DavidManzano04/control-acceso-iot/hardware/BOM_NODO_ACCESO.csv

Cantidad | Referencias | Valor | Huella (KiCad) | Parte sugerida | LCSC
1 | C1 | 100uF 25V | Capacitor_SMD:CP_Elec_6.3x7.7 | Aluminio SMD 100 uF 25 V 6.3 mm | C2941301
1 | C2 | 10uF 50V | Capacitor_SMD:C_1206_3216Metric | X5R 1206 10 uF 25 V | C13585
3 | C3 C8 C10 | 100nF | Capacitor_SMD:C_0603_1608Metric |  | C14663
2 | C4 C5 | 22uF 25V | Capacitor_SMD:C_1206_3216Metric |  | C12891
1 | C6 | 10uF 25V | Capacitor_SMD:C_0805_2012Metric |  | C15850
2 | C7 C9 | 22uF 25V | Capacitor_SMD:C_0805_2012Metric |  | C45783
1 | C11 | 1uF | Capacitor_SMD:C_0603_1608Metric |  | C15849
1 | D1 | SS34 | Diode_SMD:D_SMA | SS34 (3 A, 40 V) | C8678
1 | D2 | SMBJ15CA | Diode_SMD:D_SMB | SMBJ15CA | C8829
2 | D3 D4 | SS34 | Diode_SMD:D_SMA | SS34 | C8678
1 | D5 | PWR (rojo) | LED_SMD:LED_0603_1608Metric |  | C2286
1 | D6 | ESTADO (verde) | LED_SMD:LED_0603_1608Metric |  | C72043
1 | F1 | PTC 1.1A 16V | Fuse:Fuse_1812_4532Metric | JK-mSMD110-16 (1812, 1.1 A, 16 V) | C369171
1 | J1 | ENTRADA 12V | TerminalBlock_Phoenix:TerminalBlock_Phoenix_MKDS-1,5-2-5.08_1x02_P5.08mm_Horizontal | Phoenix MKDS 1,5/2-5,08 (1715721) | (soldar a mano)
1 | J2 | USB-C | Connector_USB:USB_C_Receptacle_HRO_TYPE-C-31-M-12 | Korean Hroparts TYPE-C-31-M-12 | C165948
1 | J3 | LECTOR | TerminalBlock_Phoenix:TerminalBlock_Phoenix_MKDS-1,5-4-5.08_1x04_P5.08mm_Horizontal | Phoenix MKDS 1,5/4-5,08 (1715747) | (soldar a mano)
1 | J4 | LECTOR CTRL | TerminalBlock_Phoenix:TerminalBlock_Phoenix_MKDS-1,5-4-5.08_1x04_P5.08mm_Horizontal | Phoenix MKDS 1,5/4-5,08 (1715747) | (soldar a mano)
1 | J8 | UART0 | Connector_PinHeader_2.54mm:PinHeader_1x04_P2.54mm_Vertical |  | (soldar a mano)
1 | J9 | EXPANSION | Connector_PinHeader_2.54mm:PinHeader_1x06_P2.54mm_Vertical |  | (soldar a mano)
1 | L1 | 6.8uH | Inductor_SMD:L_Bourns_SRN6045TA | Bourns SRN6045TA-6R8M | C135303
3 | Q1 Q2 Q3 | BSS138 | Package_TO_SOT_SMD:SOT-23 | BSS138 | C82045
2 | R1 R2 | 5.1k | Resistor_SMD:R_0603_1608Metric |  | C23186
2 | R3 R6 | 1k | Resistor_SMD:R_0603_1608Metric |  | C21190
3 | R16 R17 R18 | 1k | Resistor_SMD:R_0603_1608Metric | Serie GPIO -> lector (OK/ERR/BEEP, activo en alto) | C21190
8 | R4 R5 R7 R8 R9 R10 R11 R12 | 10k | Resistor_SMD:R_0603_1608Metric |  | C25804
3 | R13 R14 R15 | 100k | Resistor_SMD:R_0603_1608Metric |  | C25803
1 | SW1 | RESET | Button_Switch_SMD:SW_SPST_PTS810 | C&K PTS810 SJM 250 SMTR LFS | C221895
1 | SW2 | BOOT | Button_Switch_SMD:SW_SPST_PTS810 | C&K PTS810 SJM 250 SMTR LFS | C221895
1 | U1 | AP63205WU | Package_TO_SOT_SMD:TSOT-23-6 | Diodes AP63205WU-7 | C2071056
1 | U2 | USBLC6-2SC6 | Package_TO_SOT_SMD:SOT-23-6 | ST USBLC6-2SC6 | C7519
1 | U3 | AP7361C-33E | Package_TO_SOT_SMD:SOT-223-3_TabPin2 | Diodes AP7361C-33E-13 | C500795
1 | U4 | ESP32-S3-WROOM-1-N16R8 | RF_Module:ESP32-S3-WROOM-1 | Espressif ESP32-S3-WROOM-1-N16R8 | C2913202
2 | U5 U6 | SRV05-4 | Package_TO_SOT_SMD:SOT-23-6 | SRV05-4 | C338781
