DavidManzano04/control-acceso-iot/hardware/Esquematico_NODO_ACCESO.pdf

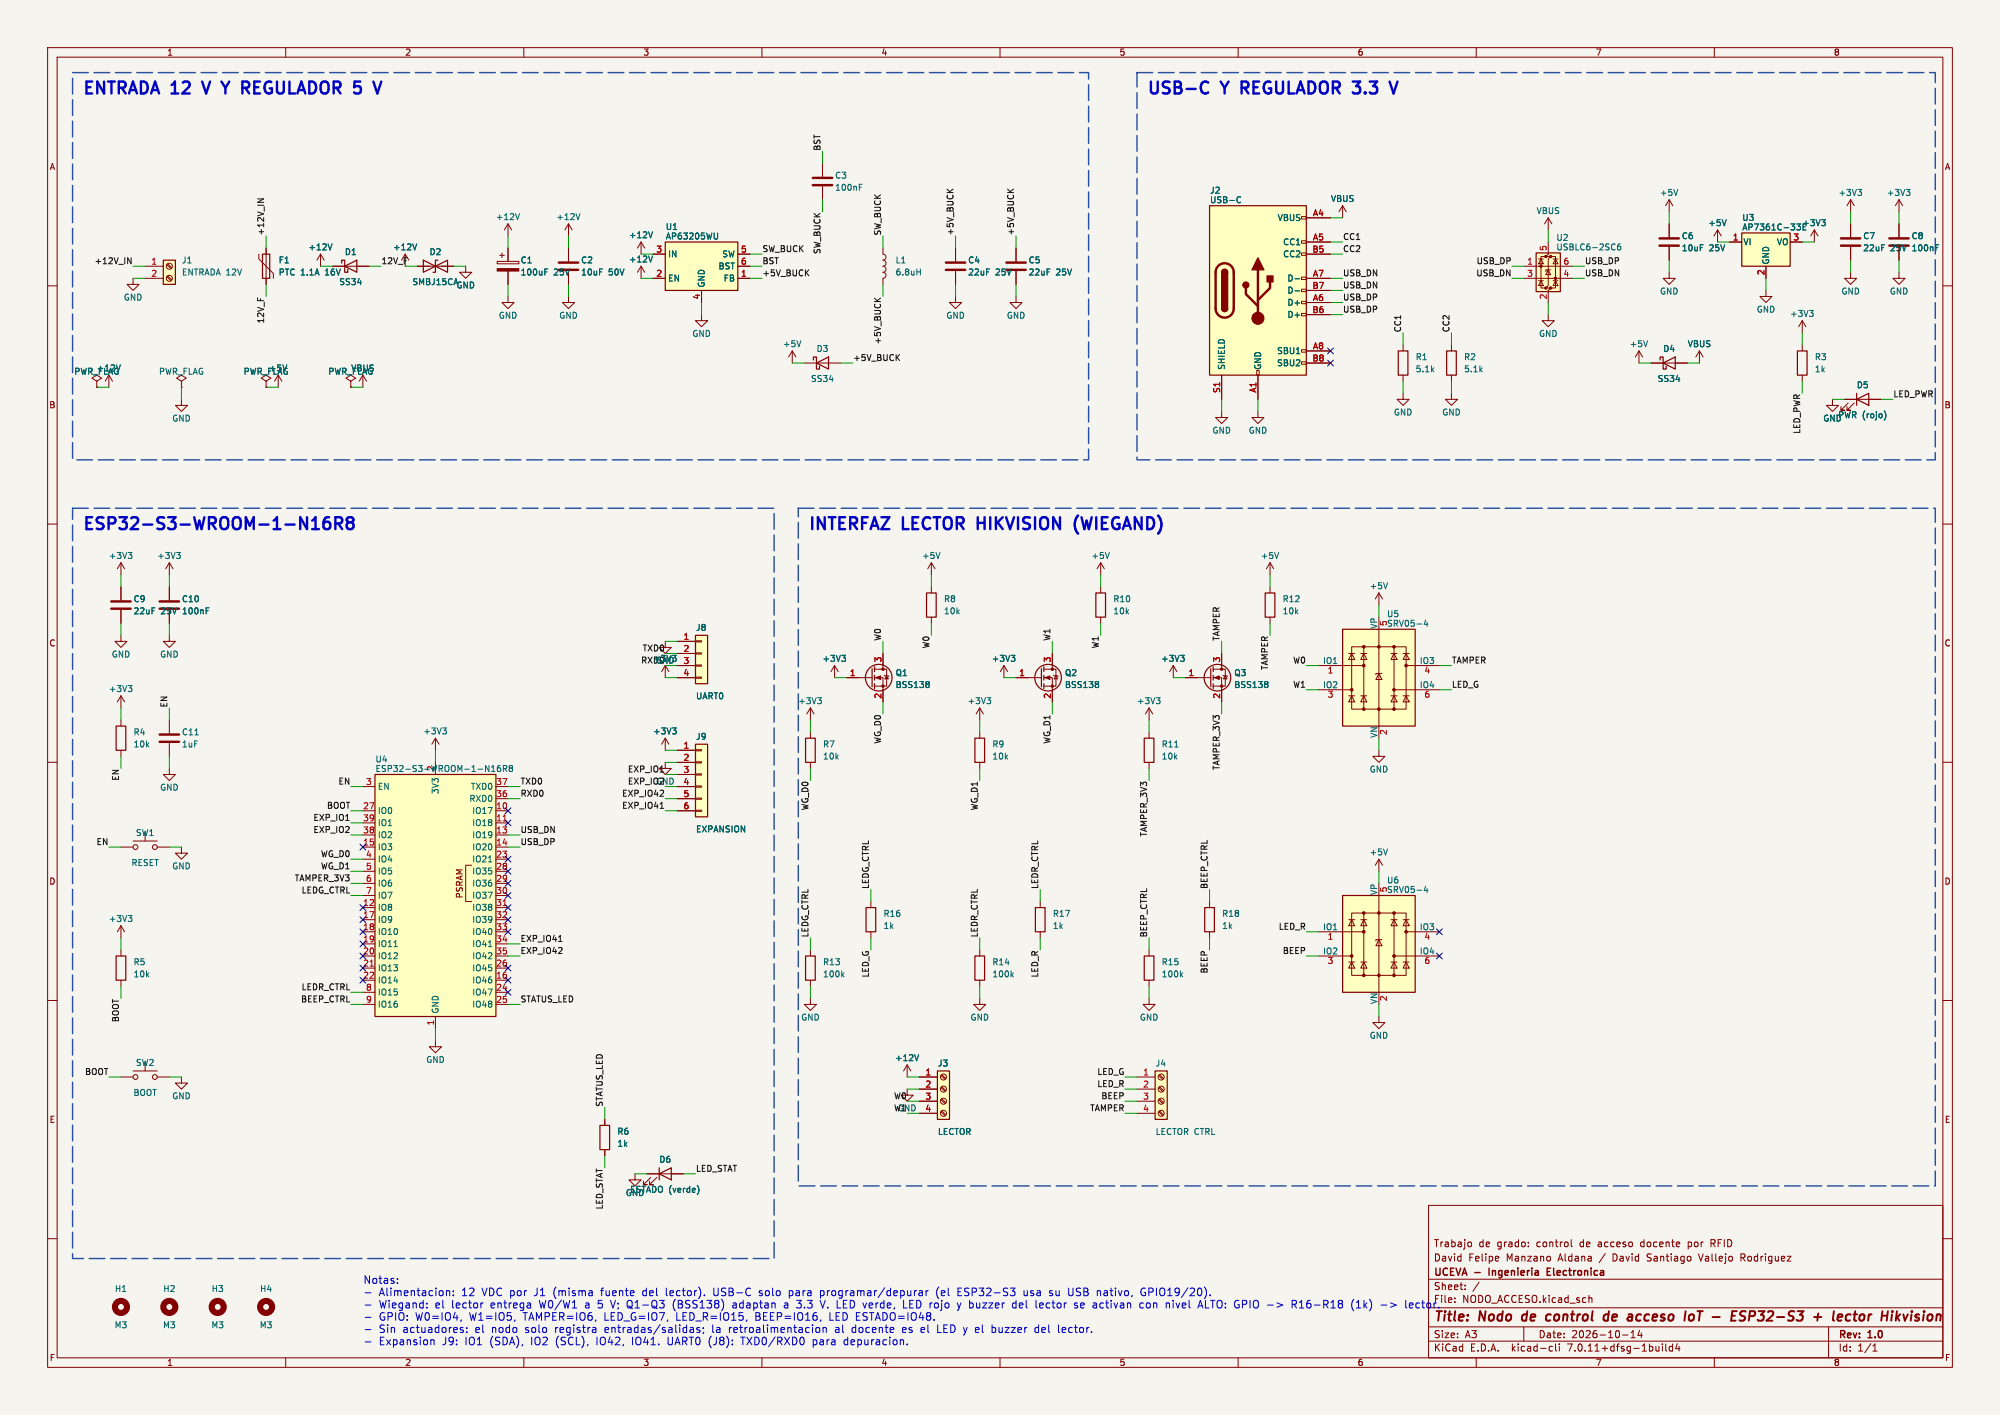
[picture p2: page 1]
