DavidManzano04/control-acceso-iot/hardware/NODO_ACCESO.kicad_pcb

## KiCad design hardware/NODO_ACCESO.kicad_pcb (2026-10-21)

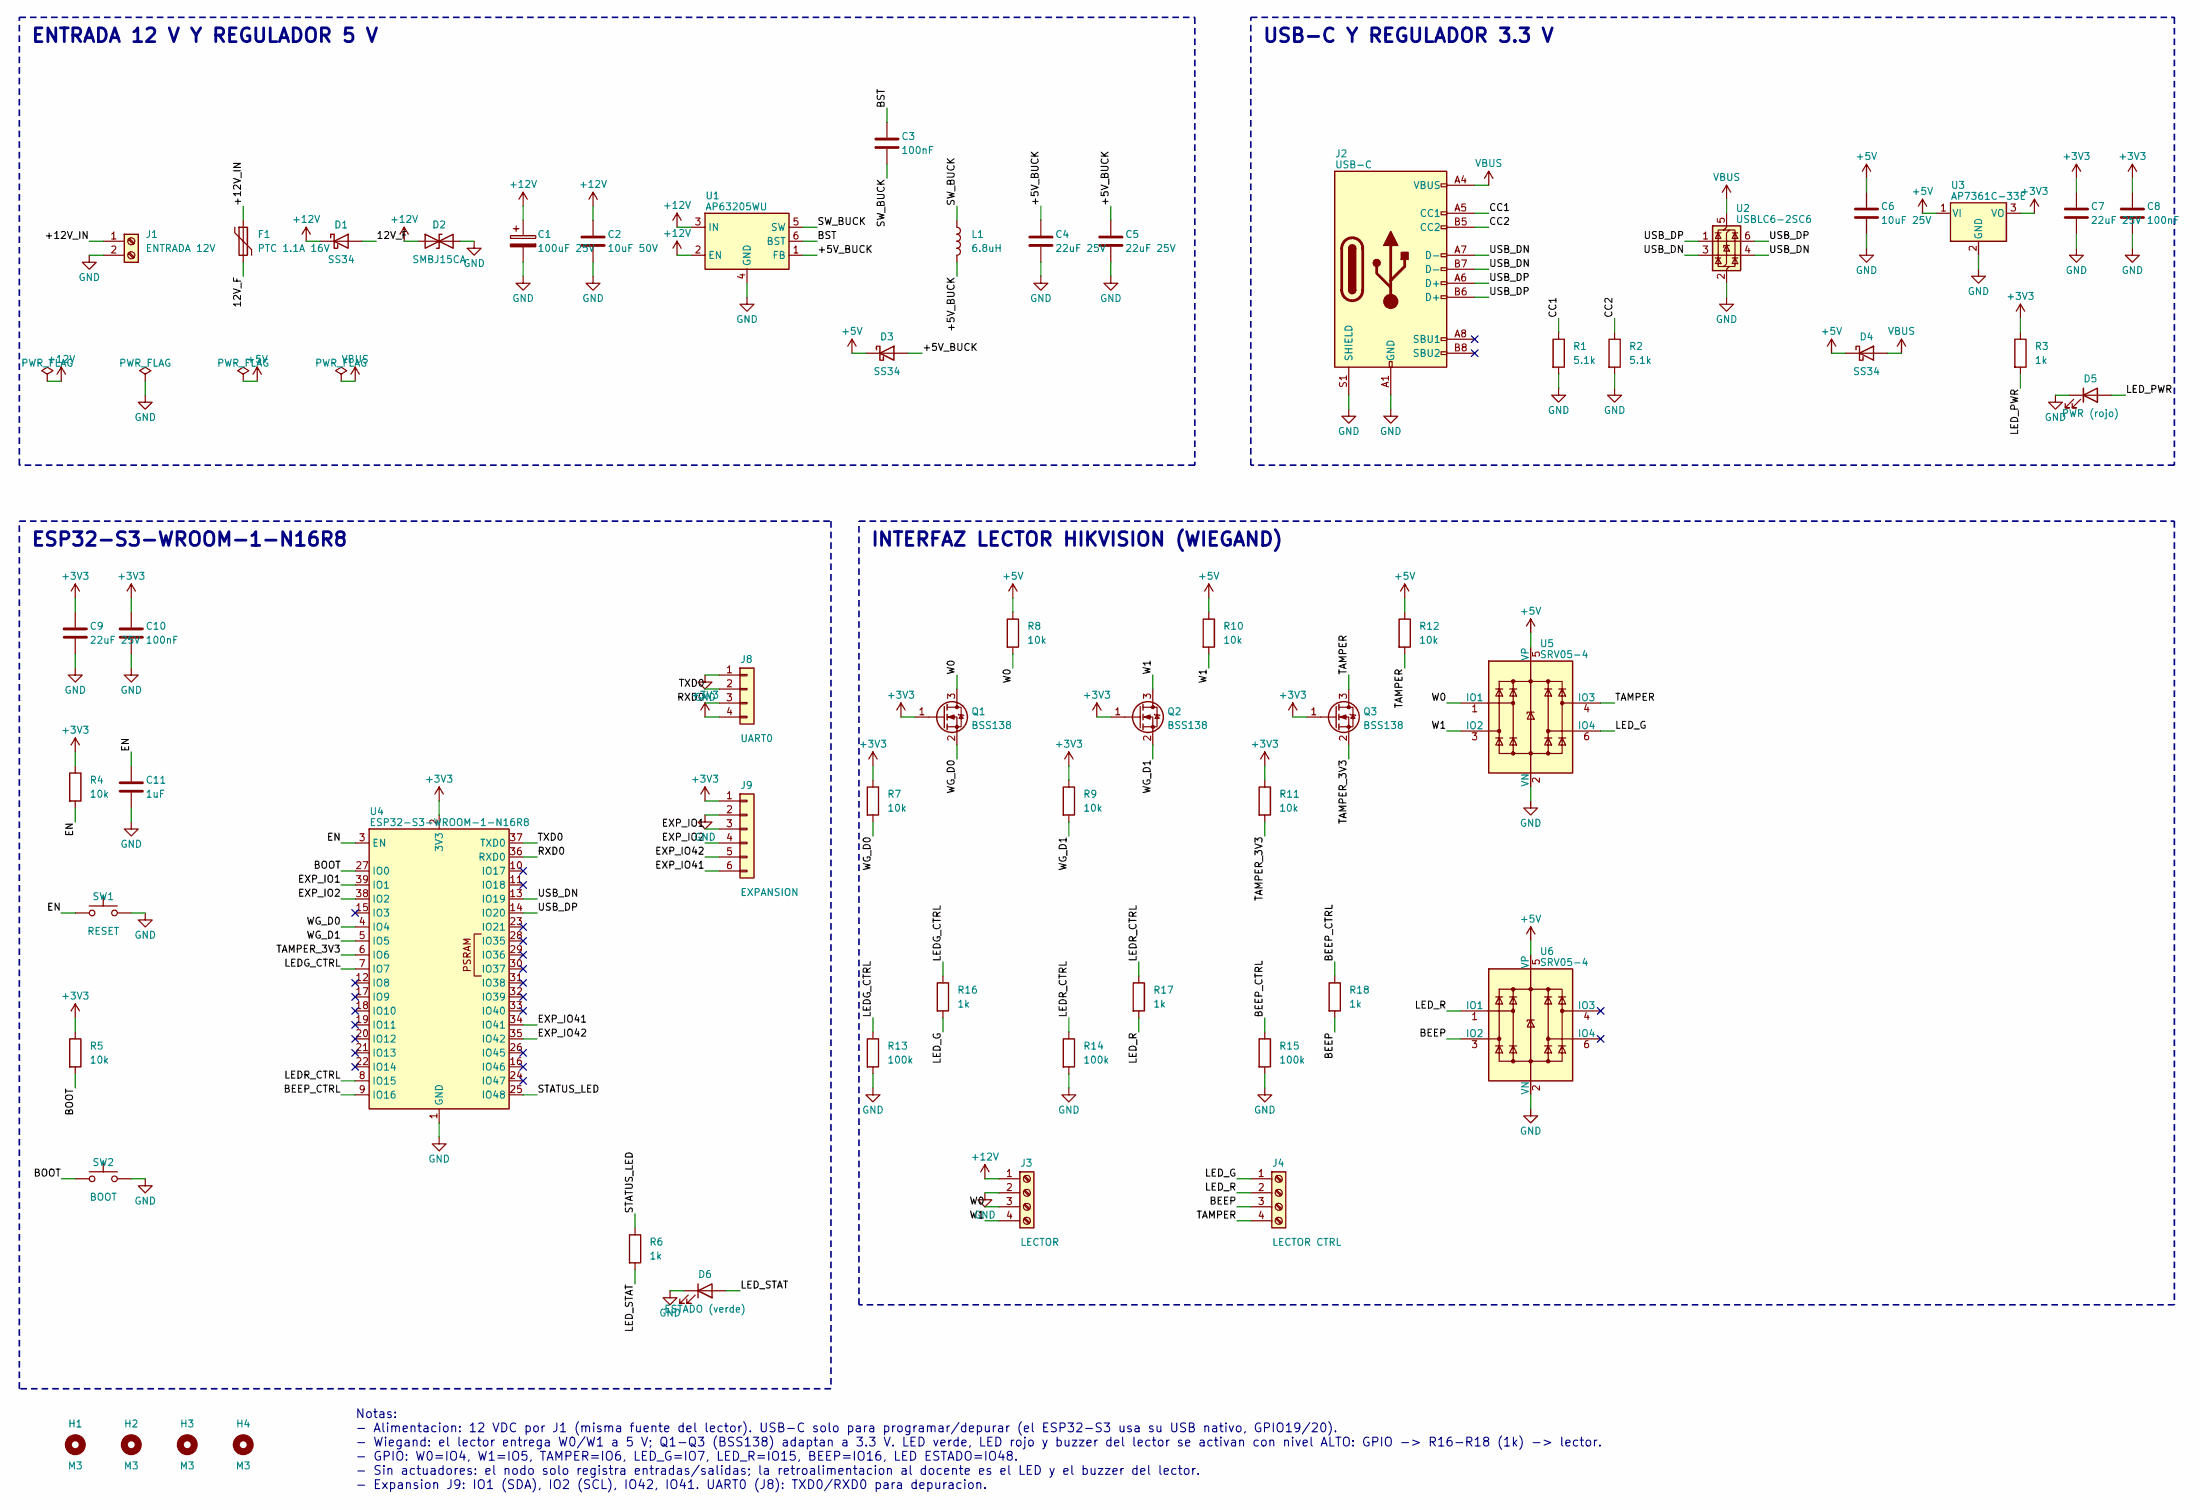
[picture p3: schematic NODO_ACCESO.kicad_sch, Nodo de control de acceso IoT - ESP32-S3 + lector Hikvision]

Parts:
C1: 100uF 25V; CP_Elec_6.3x7.7; MPN Aluminio SMD 100 uF 25 V 6.3 mm; LCSC C2941301
C2: 10uF 50V; C_1206_3216Metric; MPN X5R 1206 10 uF 25 V; LCSC C13585
C3, C8, C10: 100nF; C_0603_1608Metric; LCSC C14663
C4, C5: 22uF 25V; C_1206_3216Metric; LCSC C12891
C6: 10uF 25V; C_0805_2012Metric; LCSC C15850
C7, C9: 22uF 25V; C_0805_2012Metric; LCSC C45783
C11: 1uF; C_0603_1608Metric; LCSC C15849
D1: SS34; D_SMA; MPN SS34 (3 A, 40 V); LCSC C8678
D2: SMBJ15CA; D_SMB; MPN SMBJ15CA; LCSC C8829
D3, D4: SS34; D_SMA; MPN SS34; LCSC C8678
D5: PWR (rojo); LED_0603_1608Metric; LCSC C2286
D6: ESTADO (verde); LED_0603_1608Metric; LCSC C72043
F1: PTC 1.1A 16V; Fuse_1812_4532Metric; MPN JK-mSMD110-16 (1812, 1.1 A, 16 V); LCSC C369171
H1, H2, H3, H4: M3; MountingHole_3.2mm_M3
J1: ENTRADA 12V; TerminalBlock_Phoenix_MKDS-1,5-2-5.08_1x02_P5.08mm_Horizont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; MPN Phoenix MKDS 1,5/2-5,08 (1715721)
J2: USB-C; USB_C_Receptacle_HRO_TYPE-C-31-M-12; MPN Korean Hroparts TYPE-C-31-M-12; LCSC C165948
J3: LECTOR; TerminalBlock_Phoenix_MKDS-1,5-4-5.08_1x04_P5.08mm_Horizont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; MPN Phoenix MKDS 1,5/4-5,08 (1715747)
J4: LECTOR CTRL; TerminalBlock_Phoenix_MKDS-1,5-4-5.08_1x04_P5.08mm_Horizont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; MPN Phoenix MKDS 1,5/4-5,08 (1715747)
J8: UART0; PinHeader_1x04_P2.54mm_Vertical
J9: EXPANSION; PinHeader_1x06_P2.54mm_Vertical
L1: 6.8uH; L_Bourns_SRN6045TA; MPN Bourns SRN6045TA-6R8M; LCSC C135303
Q1, Q2, Q3: BSS138; SOT-23; MPN BSS138; LCSC C82045
R1, R2: 5.1k; R_0603_1608Metric; LCSC C23186
R3, R6, R16, R17, R18: 1k; R_0603_1608Metric; LCSC C21190
R4, R5, R7, R8, R9, R10, R11, R12: 10k; R_0603_1608Metric; LCSC C25804
R13, R14, R15: 100k; R_0603_1608Metric; LCSC C25803
SW1: RESET; SW_SPST_PTS810; MPN C&K PTS810 SJM 250 SMTR LFS; LCSC C221895
SW2: BOOT; SW_SPST_PTS810; MPN C&K PTS810 SJM 250 SMTR LFS; LCSC C221895
U1: AP63205WU; TSOT-23-6; MPN Diodes AP63205WU-7; LCSC C2071056
U2: USBLC6-2SC6; SOT-23-6; MPN ST USBLC6-2SC6; LCSC C7519
U3: AP7361C-33E; SOT-223-3_TabPin2; MPN Diodes AP7361C-33E-13; LCSC C500795
U4: ESP32-S3-WROOM-1-N16R8; ESP32-S3-WROOM-1; MPN Espressif ESP32-S3-WROOM-1-N16R8; LCSC C2913202
U5, U6: SRV05-4; SOT-23-6; MPN SRV05-4; LCSC C338781

Connections:
12V_F: D1.2 (A), F1.2
+3V3: C7.1, C8.1, C9.1, C10.1, J8.4, J9.1, Q1.1 (G), Q2.1 (G), Q3.1 (G), R3.1, R4.1, R5.1, R7.1, R9.1, R11.1, U3.3 (VO), U4.2 (3V3)
+5V: C6.1, D3.1 (K), D4.1 (K), R8.1, R10.1, R12.1, U3.1 (VI), U5.5 (VP), U6.5 (VP)
+5V_BUCK: C4.1, C5.1, D3.2 (A), L1.2, U1.1 (FB)
+12V: C1.1, C2.1, D1.1 (K), D2.1 (A1), J3.1, U1.2 (EN), U1.3 (IN)
+12V_IN: F1.1, J1.1
BEEP: J4.3, R18.2, U6.3 (IO2)
BEEP_CTRL: R15.1, R18.1, U4.9 (IO16)
BOOT: R5.2, SW2.1, U4.27 (IO0)
BST: C3.1, U1.6 (BST)
CC1: J2.A5 (CC1), R1.1
CC2: J2.B5 (CC2), R2.1
EN: C11.1, R4.2, SW1.1, U4.3 (EN)
EXP_IO1: J9.3, U4.39 (IO1)
EXP_IO2: J9.4, U4.38 (IO2)
EXP_IO41: J9.6, U4.34 (IO41)
EXP_IO42: J9.5, U4.35 (IO42)
GND: C1.2, C2.2, C4.2, C5.2, C6.2, C7.2, C8.2, C9.2, C10.2, C11.2, D2.2 (A2), D5.1 (K), D6.1 (K), J1.2, J2.A1 (GND), J2.A12 (GND), J2.B1 (GND), J2.B12 (GND), J2.S1 (SHIELD), J3.2, J8.1, J9.2, R1.2, R2.2, R13.2, R14.2, R15.2, SW1.2, SW2.2, U1.4 (GND), U2.2 (GND), U3.2 (GND), U4.1 (GND), U4.40 (GND), U4.41 (GND), U5.2 (VN), U6.2 (VN)
LEDG_CTRL: R13.1, R16.1, U4.7 (IO7)
LEDR_CTRL: R14.1, R17.1, U4.8 (IO15)
LED_G: J4.1, R16.2, U5.6 (IO4)
LED_PWR: D5.2 (A), R3.2
LED_R: J4.2, R17.2, U6.1 (IO1)
LED_STAT: D6.2 (A), R6.2
RXD0: J8.3, U4.36 (RXD0)
STATUS_LED: R6.1, U4.25 (IO48)
SW_BUCK: C3.2, L1.1, U1.5 (SW)
TAMPER: J4.4, Q3.3 (D), R12.2, U5.4 (IO3)
TAMPER_3V3: Q3.2 (S), R11.2, U4.6 (IO6)
TXD0: J8.2, U4.37 (TXD0)
USB_DN: J2.A7 (D-), J2.B7 (D-), U2.3 (I/O2), U2.4 (I/O2), U4.13 (IO19)
USB_DP: J2.A6 (D+), J2.B6 (D+), U2.1 (I/O1), U2.6 (I/O1), U4.14 (IO20)
VBUS: D4.2 (A), J2.A4 (VBUS), J2.A9 (VBUS), J2.B4 (VBUS), J2.B9 (VBUS), U2.5 (VBUS)
W0: J3.3, Q1.3 (D), R8.2, U5.1 (IO1)
W1: J3.4, Q2.3 (D), R10.2, U5.3 (IO2)
WG_D0: Q1.2 (S), R7.2, U4.4 (IO4)
WG_D1: Q2.2 (S), R9.2, U4.5 (IO5)

Notes on the sheet:
ENTRADA 12 V Y REGULADOR 5 V
USB-C Y REGULADOR 3.3 V
ESP32-S3-WROOM-1-N16R8
INTERFAZ LECTOR HIKVISION (WIEGAND)
Notas: - Alimentacion: 12 VDC por J1 (misma fuente del lector). USB-C solo para programar/depurar (el ESP32-S3 usa su USB nativo, GPIO19/20). - Wiegand: el lector entrega W0/W1 a 5 V; Q1-Q3 (BSS138) adaptan a 3.3 V. LED verde, LED rojo y buzzer del lector se activan con nivel ALTO: GPIO -> R16-R18 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

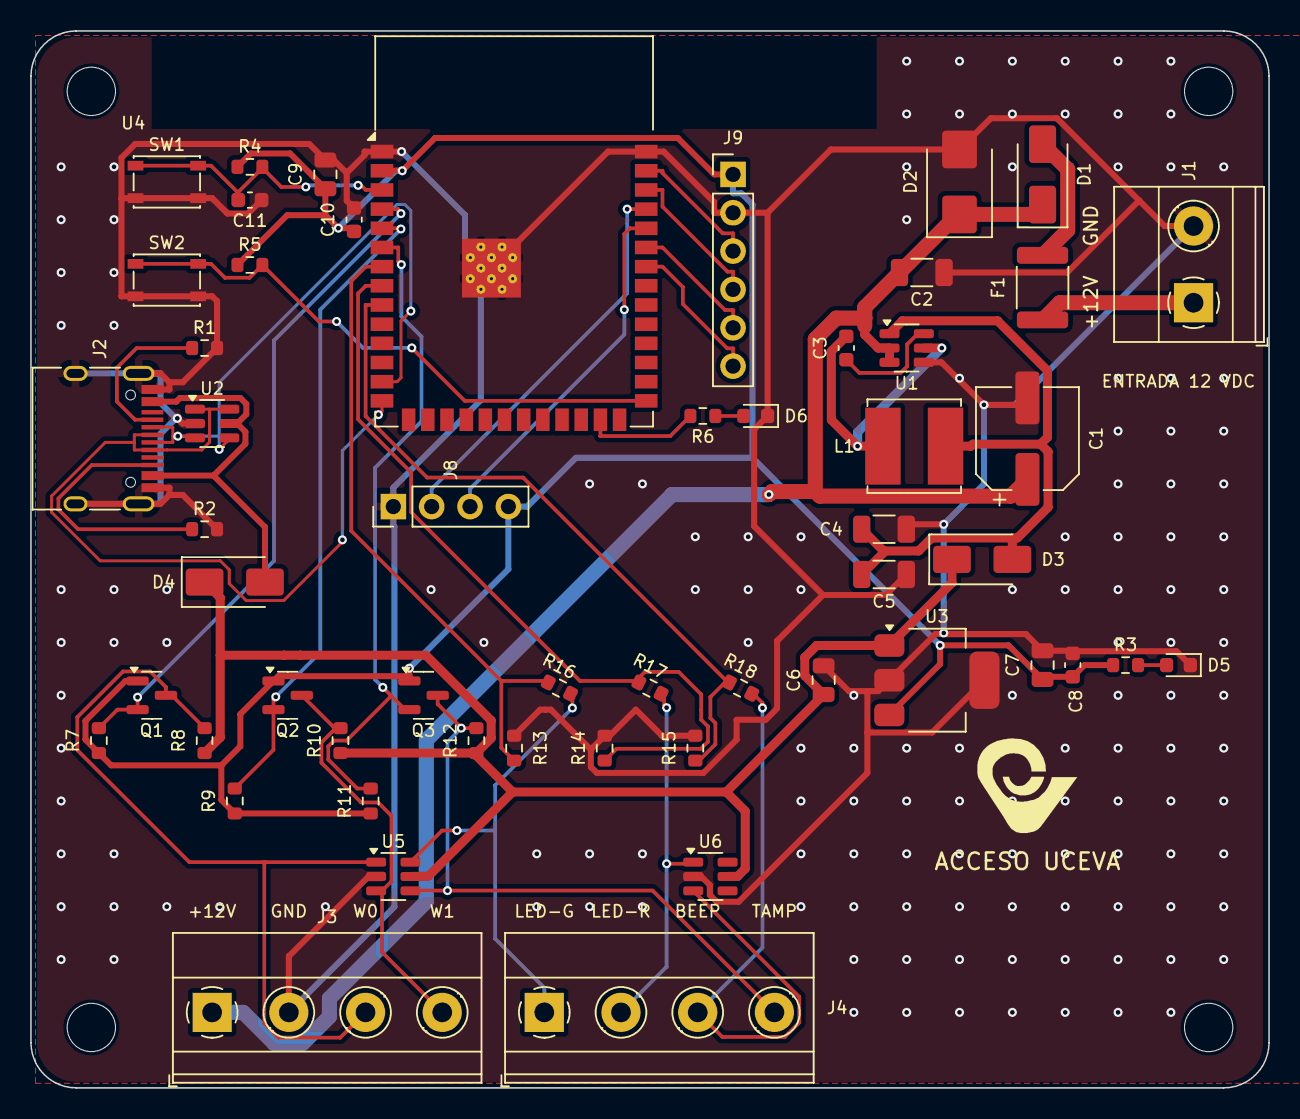
[picture p4: board NODO_ACCESO.kicad_pcb from above]

Board: 2 copper layers, 82.0 x 70.0 mm, 58 parts (0 on the bottom side), 37 nets.
